zSkip/Charter-Project/drone-rail/00-base-section/p1_base_section_iso.png

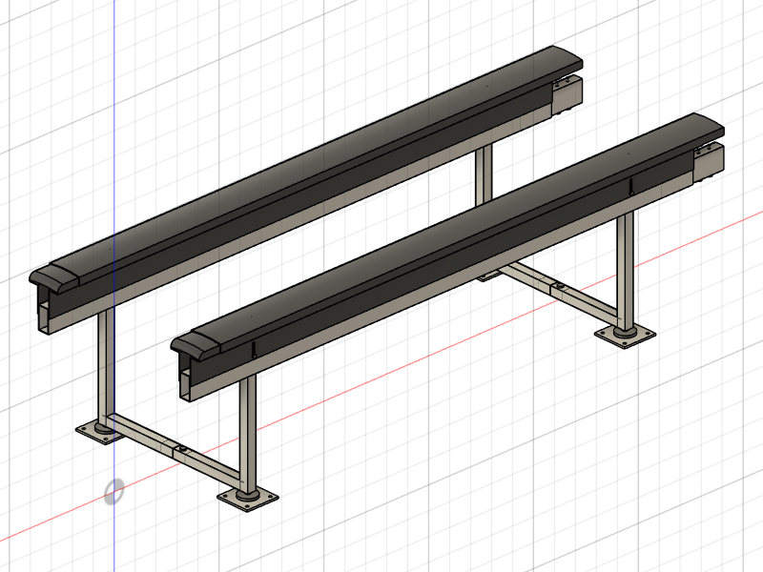
drone-rail/00-base-section/p1_base_section_iso.png
