zSkip/Charter-Project/drone-rail/01-entry/G1-funnel/p1_run_top_check.png

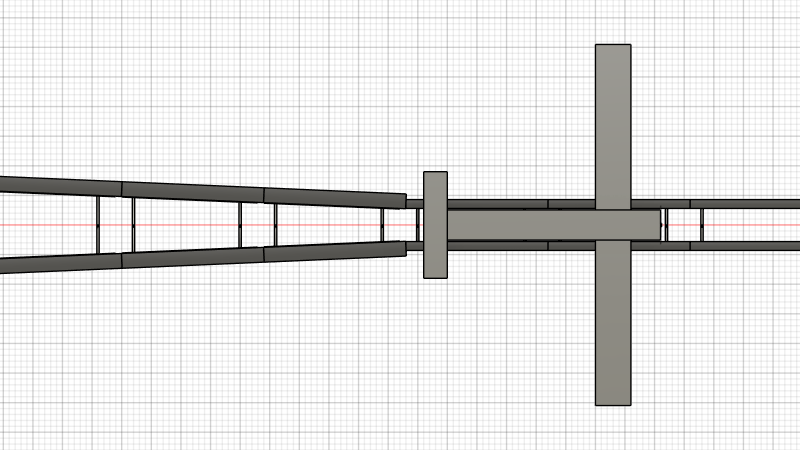
drone-rail/01-entry/G1-funnel/p1_run_top_check.png
