zSkip/Charter-Project/drone-rail/03-damping/S1-springs-only/p1_spring_point_cap_hidden.png

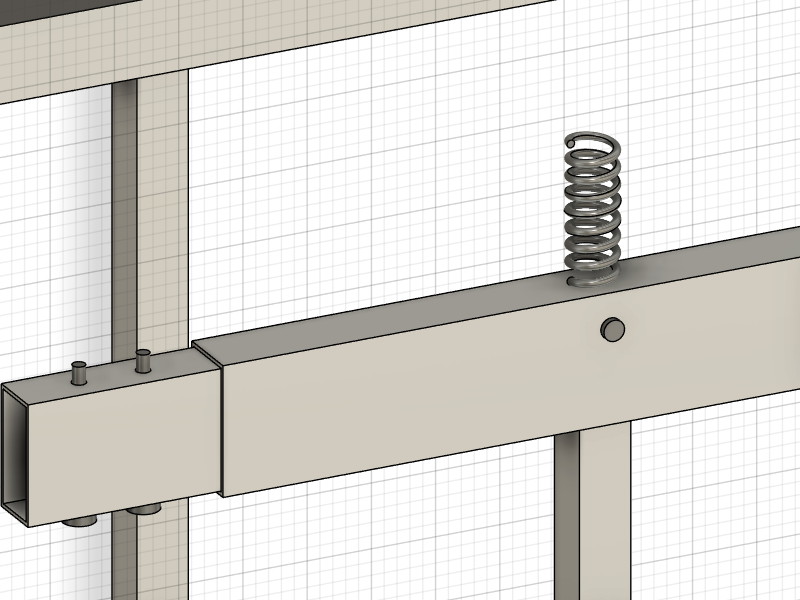
drone-rail/03-damping/S1-springs-only/p1_spring_point_cap_hidden.png
