zSkip/Charter-Project/(list of files, cad)

Other CAD files:
drone-rail/00-base-section/DRR_base_section.f3d
drone-rail/00-base-section/DRR_base_section_simple.f3d
drone-rail/01-entry/G1-funnel/DRR_G1_run_3_section.f3d
drone-rail/02-stopping/A-friction-only/DRR_A_friction_only.f3d
drone-rail/02-stopping/B-braking-zone/DRR_B_braking_zone.f3d
drone-rail/02-stopping/C-uphill-ramp/DRR_C_uphill_ramp.f3d
drone-rail/02-stopping/D1-catch-net/DRR_D1_catch_net.f3d
drone-rail/02-stopping/D1-catch-net/DRR_D1_net.f3d
drone-rail/02-stopping/D2-rising-grip/DRR_D2_rising_grip.f3d
drone-rail/02-stopping/D3-arresting-cable/DRR_D3_arresting_cable.f3d
drone-rail/03-damping/S1-springs-only/DRR_S1_spring_point.f3d
drone-rail/04-mounting/M1-levelling-feet/DRR_M1_bolt_down_plate.f3d
drone-rail/04-mounting/M1-levelling-feet/DRR_M1_levelling_foot.f3d
