zSkip/Charter-Project/(commit log)

2026-11-05 Add drone rail recovery concept: README, spec and sketch
    Project overview, design spec agreed in planning, and the original
    notebook sketch. Version folders, build scripts, pictures and Fusion
    models follow as each build group finishes.
2026-11-05 Add base section, G1 funnel, S1 springs and M1 feet
    Phase 1 plus the approved fixes: tail-height requirement, 2 mm walls
    and 2.0 m sections (23.2 kg per section), funnel exit splice,
    step-free first cap and tapered guide strips. Each version folder has
    its build script, PNG pictures and Fusion .f3d model. Shared build code
    is in fusion-scripts/, and progress.md documents the folder layout.
    [DRR_G1_run_3_section.f3d, DRR_M1_bolt_down_plate.f3d, DRR_M1_levelling_foot.f3d, DRR_S1_spring_point.f3d, DRR_base_section.f3d]
2026-11-06 Add stopping versions A-D3, simple section, catch net and model gallery
    - Task 0: G1 funnel exit hoods get the base cap crown; cap clash fixed and re-exported
    - DRR Base Section Simple: light linked stand-in for long runs
    - 02-stopping: A friction only, B braking zone, C uphill ramp, D1 catch net,
    D2 rising grip, D3 arresting cable (build scripts, pictures, .f3d exports)
    - C has an open clash at the 5 degree kink splice (see progress.md issue 5)
    - drone-rail/MODELS.md: picture and short explanation of every model
    - progress.md and README updated (linked designs are not embedded in .f3d)
    [DRR_A_friction_only.f3d, DRR_B_braking_zone.f3d, DRR_C_uphill_ramp.f3d, DRR_D1_catch_net.f3d, DRR_D1_net.f3d, DRR_D2_rising_grip.f3d, DRR_D3_arresting_cable.f3d, DRR_G1_run_3_section.f3d]
2026-11-06 Merge model gallery into README
    The pictures and short explanations from drone-rail/MODELS.md now form the
    Models section of the root README; MODELS.md is removed.
